kevrsc/vermiculture-sensors/secrets-example.h

#pragma once

// Copy this file to secrets.h and fill in the Wi-Fi and endpoint info.
// The ESP32 posts to this PC's LAN address. 
#define WIFI_SSID ""
#define WIFI_PASSWORD ""
#define SERVER_URL "http://[...]/readings"
