kevrsc/vermiculture-sensors/(commit log)

2026-10-25 Update the ui with better temperature display, add night mode
2026-10-25 Add temperature range target bands
2026-10-25 Add post object containing esp32 status fields for ui monitoring
2026-10-25 Update radio keep-alive settings in attempt to avoid power bank lower power mode shut off.
    [vermiculture-sensors.ino]
2026-10-25 Simplify temperature measurement display, disable bluetooth alive pulse for now
2026-10-25 Reorder temperature probe readings in web ui
2026-10-27 Move the web server to the esp32
2026-11-06 Add support for soil moisture sensors
2026-11-06 Improve readme with background, hardware, and wiring info
